ghosty141/eurorack-psu/eurorack_psu.kicad_pcb

## KiCad design eurorack_psu.kicad_pcb (2023-08-17)

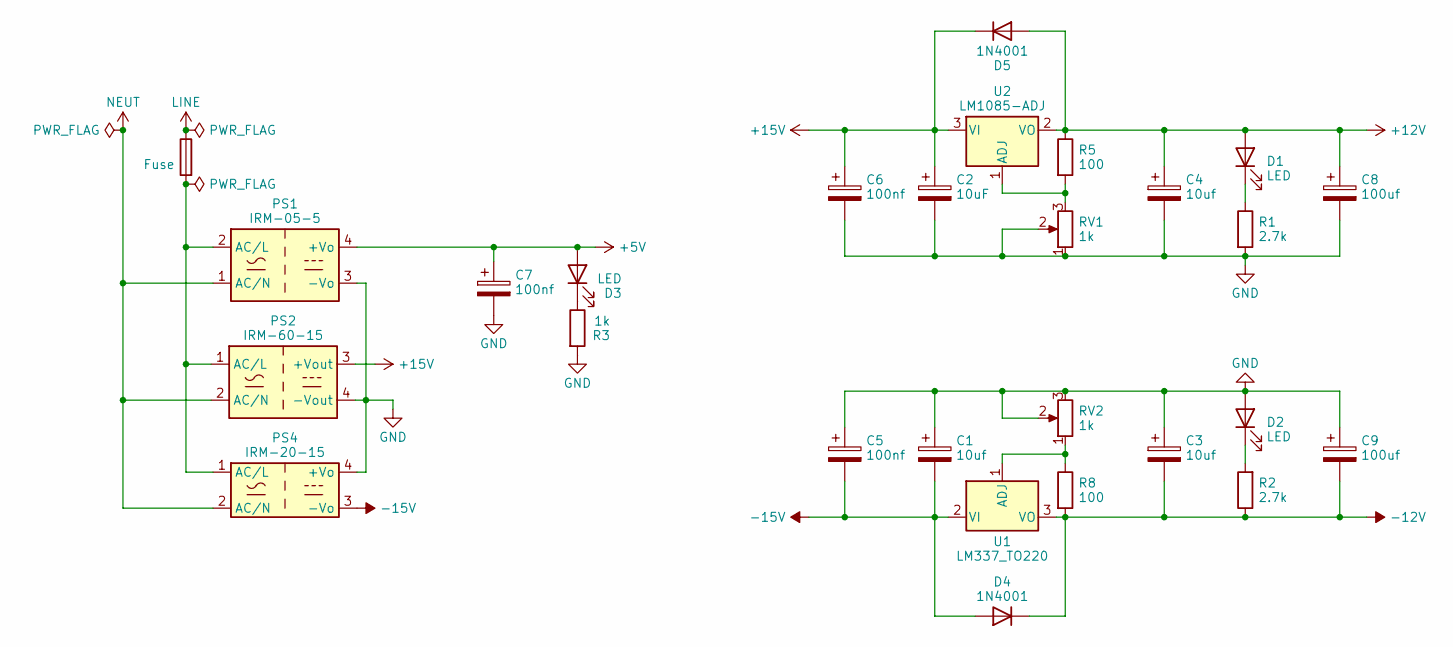
[picture p1: schematic eurorack_psu.kicad_sch]

Parts:
C1, C3, C4: 10uf; CP_EIA-6032-28_Kemet-C_Pad2.25x2.35mm_HandSolder
C2: 10uF; CP_EIA-6032-28_Kemet-C_Pad2.25x2.35mm_HandSolder
C5, C6, C7: 100nf; C_1206_3216Metric_Pad1.33x1.80mm_HandSolder
C8, C9: 100uf; CP_EIA-7343-31_Kemet-D_Pad2.25x2.55mm_HandSolder
D1, D2, D3: LED; LED_D5.0mm
D4, D5: 1N4001; D_DO-41_SOD81_P10.16mm_Horizontal
F1: Fuse; Fuseholder_Littelfuse_646
PS1: IRM-05-5; Converter_ACDC_MeanWell_IRM-05-xx_THT
PS2: IRM-60-15; Converter_ACDC_MeanWell_IRM-60-xx_THT
PS4: IRM-20-15; Converter_ACDC_MeanWell_IRM-20-xx_THT
R1, R2: 2.7k; R_Axial_DIN0207_L6.3mm_D2.5mm_P10.16mm_Horizontal
R3: 1k; R_Axial_DIN0207_L6.3mm_D2.5mm_P10.16mm_Horizontal
R5, R8: 100; R_Axial_DIN0207_L6.3mm_D2.5mm_P10.16mm_Horizontal
RV1, RV2: 1k; Potentiometer_Bourns_3299W_Vertical
U1: LM337_TO220; TO-220-3_Horizontal_TabUp
U2: LM1085-ADJ; TO-220-3_Horizontal_TabUp

Connections:
+5V: C7.1, D3.2 (A), PS1.4 (+Vo)
+12V: C4.1, C8.1, D1.2 (A), D5.2 (A), R5.1, U2.2 (VO)
+15V: C2.1, C6.1, D5.1 (K), PS2.3 (+Vout), U2.3 (VI)
-12V: C3.2, C9.2, D4.1 (K), R2.1, R8.2, U1.3 (VO)
-15V: C1.2, C5.2, D4.2 (A), PS4.3 (-Vo), U1.2 (VI)
GND: C1.1, C2.2, C3.1, C4.2, C5.1, C6.2, C7.2, C8.2, C9.1, D2.2 (A), PS1.3 (-Vo), PS2.4 (-Vout), PS4.4 (+Vo), R1.2, R3.2, RV1.1, RV1.2, RV2.2, RV2.3
LINE: F1.1
NEUT: PS1.1 (AC/N), PS2.2 (AC/N), PS4.2 (AC/N)
unnamed: D1.1 (K), R1.1
unnamed: D2.1 (K), R2.2
unnamed: D3.1 (K), R3.1
unnamed: F1.2, PS1.2 (AC/L), PS2.1 (AC/L), PS4.1 (AC/L)
unnamed: R8.1, RV2.1, U1.1 (ADJ)
unnamed: R5.2, RV1.3, U2.1 (ADJ)

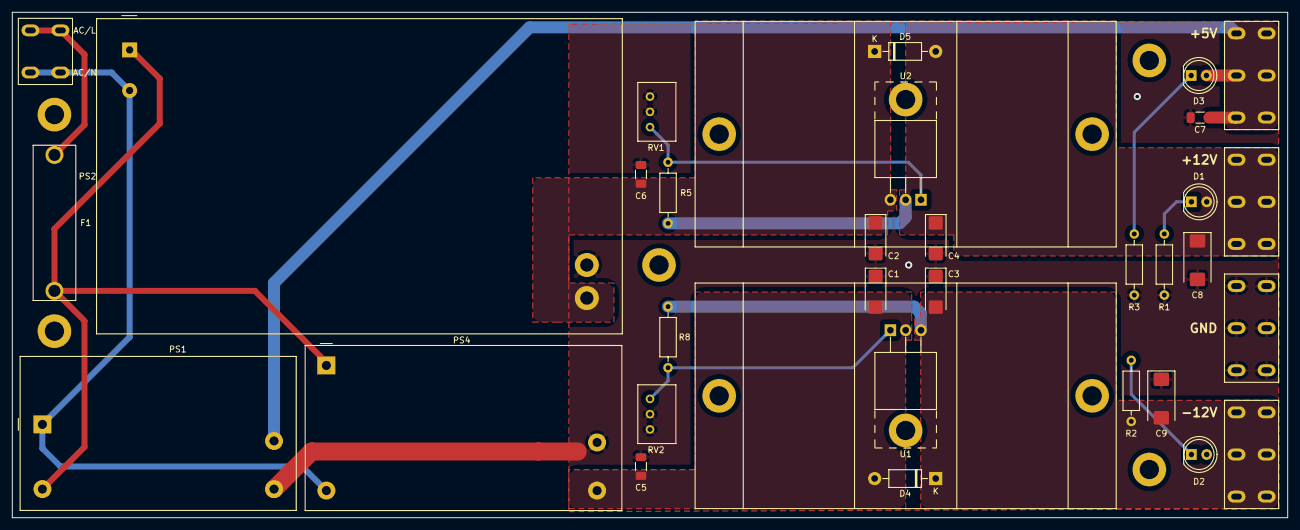
[picture p2: board eurorack_psu.kicad_pcb from above]

Board: 2 copper layers, 212.0 x 84.0 mm, 27 parts (0 on the bottom side), 13 nets.
